samanbeer/bambulab_kinda_smart_light/KiCAD_project/kicad_BOM_export.csv

Reference | Qty | Value | Footprint
D1,D2 | 2 | 1N4007 | Diode_THT:D_DO-41_SOD81_P2.54mm_Vertical_AnodeUp
D3 | 1 | LED | LED_THT:LED_D3.0mm
J1,J2 | 2 | Screw_Terminal_01x02 | TerminalBlock_RND:TerminalBlock_RND_205-00001_1x02_P5.00mm_Horizontal
J3 | 1 | INPUT__DC_JACK_24V | Connector_AMASS:AMASS_XT30U-F_1x02_P5.0mm_Vertical
J4 | 1 | FUSE_500mA | Connector_AMASS:AMASS_XT30U-F_1x02_P5.0mm_Vertical
Q1,Q2 | 2 | IRLZ44N | Package_TO_SOT_THT:TO-220-3_Vertical
R1,R4 | 2 | 100R | Resistor_SMD:R_0805_2012Metric_Pad1.20x1.40mm_HandSolder
R2,R3 | 2 | 10k | Resistor_SMD:R_0805_2012Metric_Pad1.20x1.40mm_HandSolder
R6 | 1 | 1k | Resistor_SMD:R_0805_2012Metric_Pad1.20x1.40mm_HandSolder
SW1,SW2 | 2 | SW_SPDT | Connector_PinSocket_2.54mm:PinSocket_1x03_P2.54mm_Vertical
U1 | 1 | XIAO-ESP32-C3-SMD | Seeed_Studio_XIAO_Series:XIAO-ESP32-C3-SMD
