samanbeer/bambulab_kinda_smart_light/quick_order_TME.csv

Customer's symbol | Symbol | Manufacturer part number | Manufacturer | Amount | Unit | Net price | Gross price | Net value | Gross value | Currency
 | 1N5819-DIO | 1N5819 | DIOTEC SEMICONDUCTOR | 2 | pcs | 5.6433 | 6.77 | 11.19 | 13.54 | CZK
 | L-934LID | L-934LID | KINGBRIGHT ELECTRONIC | 1 | pcs | 1.8738 | 2.36 | 1.95 | 2.36 | CZK
 | DG301-5.0-2P12 | DG301-5.0-02P-12-00A(H) | DEGSON ELECTRONICS | 2 | pcs | 3.848 | 4.63 | 7.65 | 9.26 | CZK
 | PC-GM2.5 | PC-GM2.5 | NINIGI | 1 | pcs | 76.52 | 92.59 | 76.52 | 92.59 | CZK
 | R3-12E | R3-12E | SCI | 2 | pcs | 20.397 | 24.73 | 40.88 | 49.46 | CZK
 | IRLZ44NPBF | IRLZ44NPBF | INFINEON TECHNOLOGIES | 2 | pcs | 33.753 | 40.785 | 67.41 | 81.57 | CZK
 | CRCW0805100RFKTABC | CRCW0805100RFKTABC | VISHAY | 2 | pcs | 0.22461 | 0.295 | 0.49 | 0.59 | CZK
 | CRCW080510K0FKEA | CRCW080510K0FKEA | VISHAY | 2 | pcs | 0.16913 | 0.145 | 0.24 | 0.29 | CZK
 | RC0805FR-071K | RC0805FR-071KL | YAGEO | 1 | pcs | 1.23792 | 1.48 | 1.22 | 1.48 | CZK
 | SEEED-113991054 | XIAO ESP32C3 | SEEED STUDIO | 1 | pcs | 139.04 | 168.24 | 139.04 | 168.24 | CZK
 | BSI-10 | SSI-10 | SUNGMUN ELECTRONICS | 2 | pcs | 12.654 | 15.315 | 25.31 | 30.63 | CZK
