samanbeer/bambulab_kinda_smart_light/CAD/CASE_Bottom.step

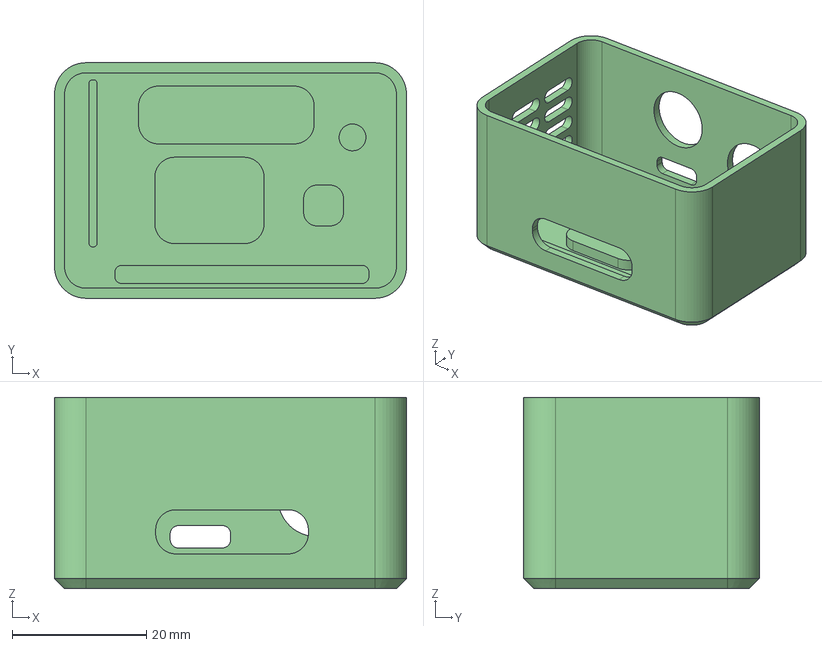
[picture p15: CAD file, 2026-10-30]
CAD/CASE_Bottom.step
52.4 x 35.1 x 28.5 mm
