samanbeer/bambulab_kinda_smart_light/KiCAD_project/kicad_3dmodels/XIAO ESP32C3--3DModel-STEP-269445.STEP

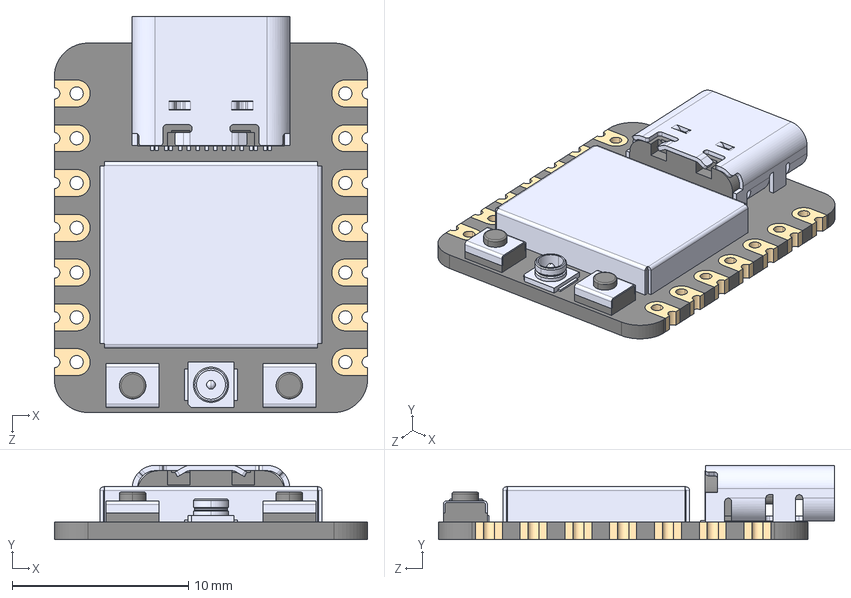
[picture p16: CAD file, 2026-10-30]
KiCAD_project/kicad_3dmodels/XIAO ESP32C3--3DModel-STEP-269445.STEP
17.8 x 4.21 x 22.5 mm
