samanbeer/bambulab_kinda_smart_light/CAD/CASE_lid.step

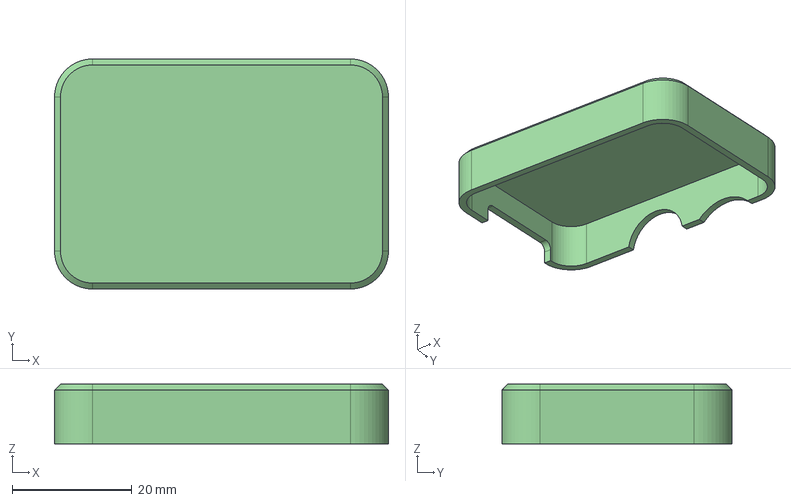
[picture p17: CAD file, 2026-10-30]
CAD/CASE_lid.step
55.7 x 38.4 x 10.0 mm
