samanbeer/bambulab_kinda_smart_light/KiCAD_project/kicad_3dmodels/Same_Sky_TB006-508-02BE.step

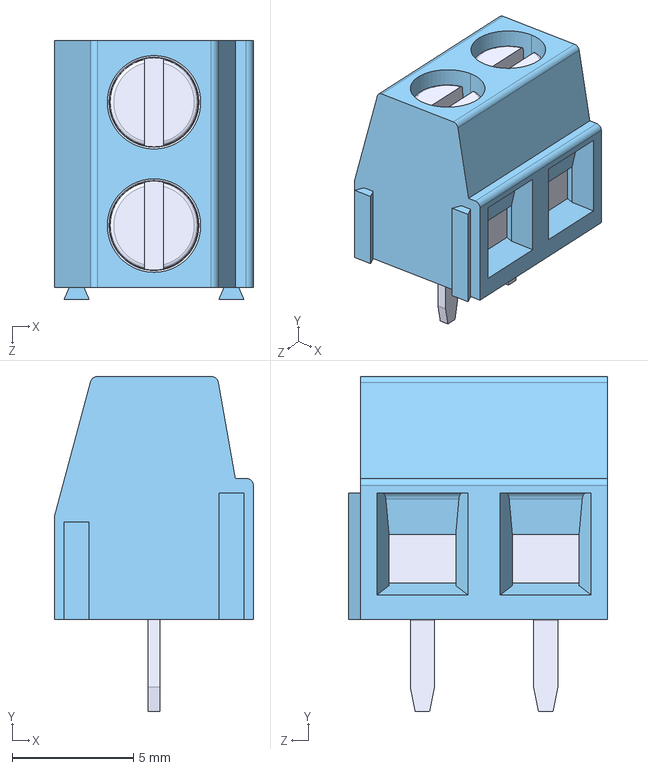
[picture p18: CAD file, 2026-10-30]
KiCAD_project/kicad_3dmodels/Same_Sky_TB006-508-02BE.step
8.20 x 13.8 x 10.7 mm
