samanbeer/bambulab_kinda_smart_light/CAD/KiCAD_PCB_export.step

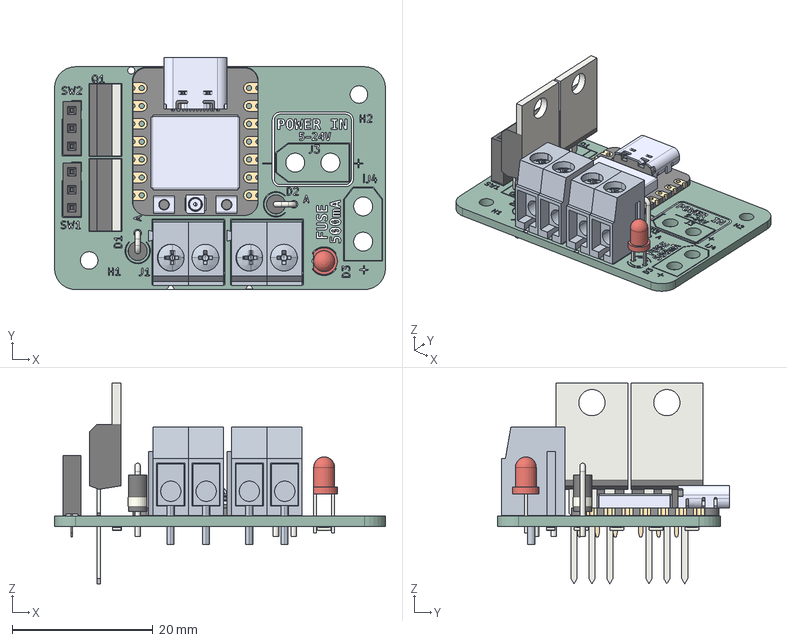
[picture p19: CAD file, 2026-10-30]
CAD/KiCAD_PCB_export.step
47.0 x 33.0 x 28.5 mm
TO-220-3_Vertical x 2
LED_D3.0mm
D_DO-41_SOD81_P2.54mm_Vertical_AnodeUp x 2
PinSocket_1x03_P2.54mm_Vertical x 2
CTB1202,2BK x 2
R_0805_2012Metric x 5
smarthome1_silkscreen x 2
smarthome1_PCB
