samanbeer/bambulab_kinda_smart_light/KiCAD_project/kicad_3dmodels/RND 205-00001--3DModel-STEP-269445.STEP

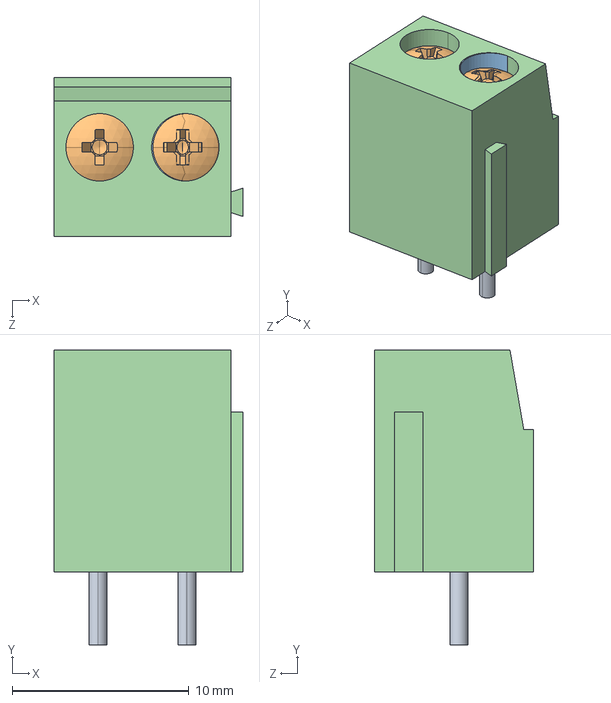
[picture p20: CAD file, 2026-10-30]
KiCAD_project/kicad_3dmodels/RND 205-00001--3DModel-STEP-269445.STEP
10.7 x 16.7 x 9.02 mm
