samanbeer/bambulab_kinda_smart_light/(list of files, cad)

Other CAD files:
CAD/CASE_full_assembly.f3z
