samanbeer/bambulab_kinda_smart_light/KiCAD_project/smarthome1.kicad_pcb

## KiCad design KiCAD_project/smarthome1.kicad_pcb (2026-10-30)

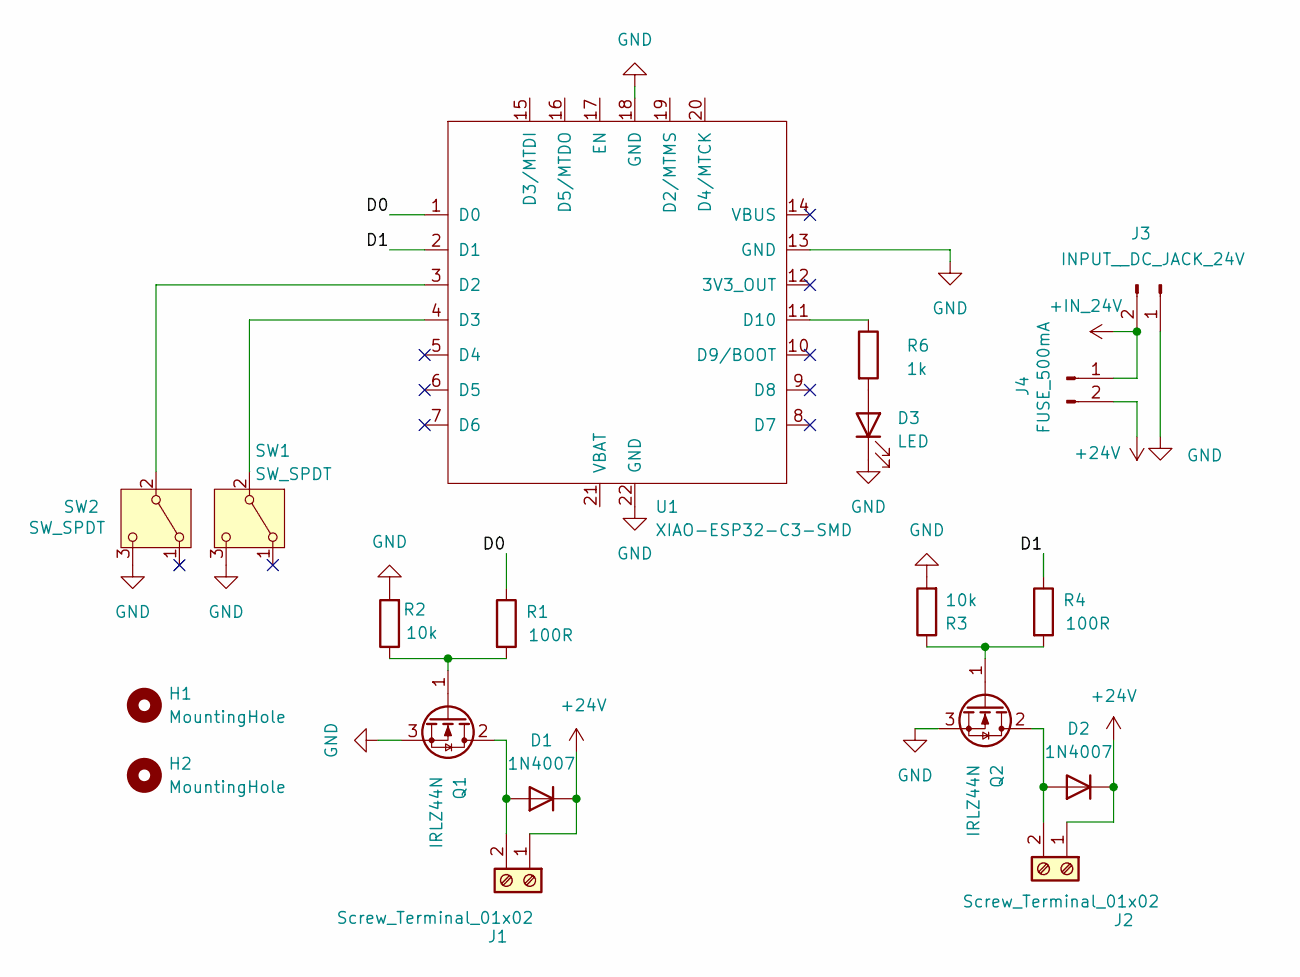
[picture p21: schematic smarthome1.kicad_sch]

Parts:
D1, D2: 1N4007; D_DO-41_SOD81_P2.54mm_Vertical_AnodeUp
D3: LED; LED_D3.0mm
H1, H2: MountingHole; MountingHole_2.5mm
J1, J2: Screw_Terminal_01x02; TerminalBlock_RND_205-00001_1x02_P5.00mm_Horizontal
J3: INPUT__DC_JACK_24V; AMASS_XT30U-F_1x02_P5.0mm_Vertical
J4: FUSE_500mA; AMASS_XT30U-F_1x02_P5.0mm_Vertical
Q1, Q2: IRLZ44N; TO-220-3_Vertical
R1, R4: 100R; R_0805_2012Metric_Pad1.20x1.40mm_HandSolder
R2, R3: 10k; R_0805_2012Metric_Pad1.20x1.40mm_HandSolder
R6: 1k; R_0805_2012Metric_Pad1.20x1.40mm_HandSolder
SW1, SW2: SW_SPDT; PinSocket_1x03_P2.54mm_Vertical
U1: XIAO-ESP32-C3-SMD

Connections:
+24V: D1.1 (K), D2.1 (K), J1.1, J2.1, J4.2
+IN_24V: J3.2, J4.1
/D0: R1.1, U1.1 (D0)
/D1: R4.1, U1.2 (D1)
GND: D3.1 (K), J3.1, Q1.3 (S), Q2.3 (S), R2.2, R3.2, SW1.3 (C), SW2.3 (C), U1.13 (GND), U1.18 (GND), U1.22 (GND)
unnamed: D1.2 (A), J1.2, Q1.2 (D)
unnamed: D2.2 (A), J2.2, Q2.2 (D)
unnamed: D3.2 (A), R6.2
unnamed: Q1.1 (G), R1.2, R2.1
unnamed: Q2.1 (G), R3.1, R4.2
unnamed: SW1.2 (B), U1.4 (D3)
unnamed: SW2.2 (B), U1.3 (D2)
unnamed: R6.1, U1.11 (D10)

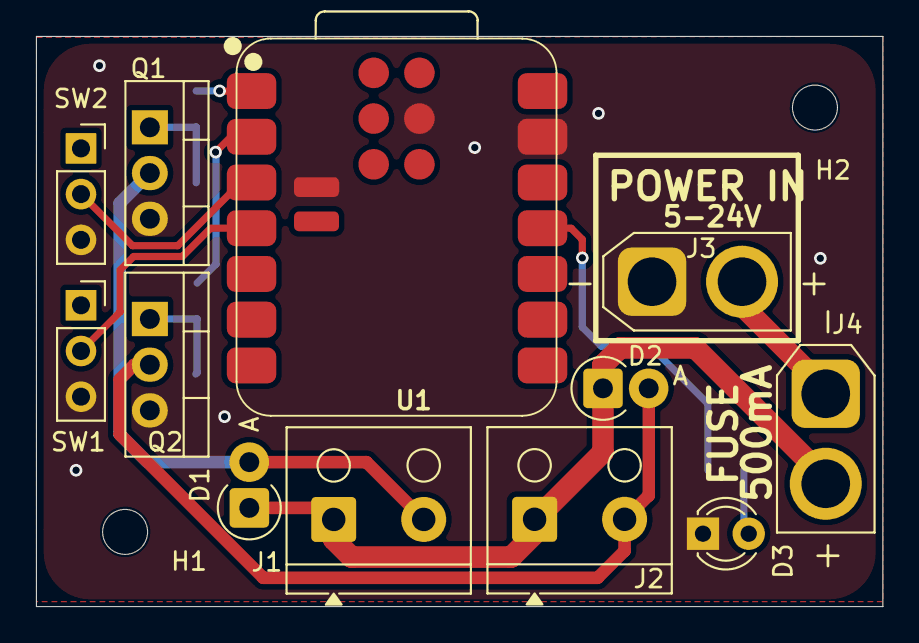
[picture p22: board smarthome1.kicad_pcb from above]

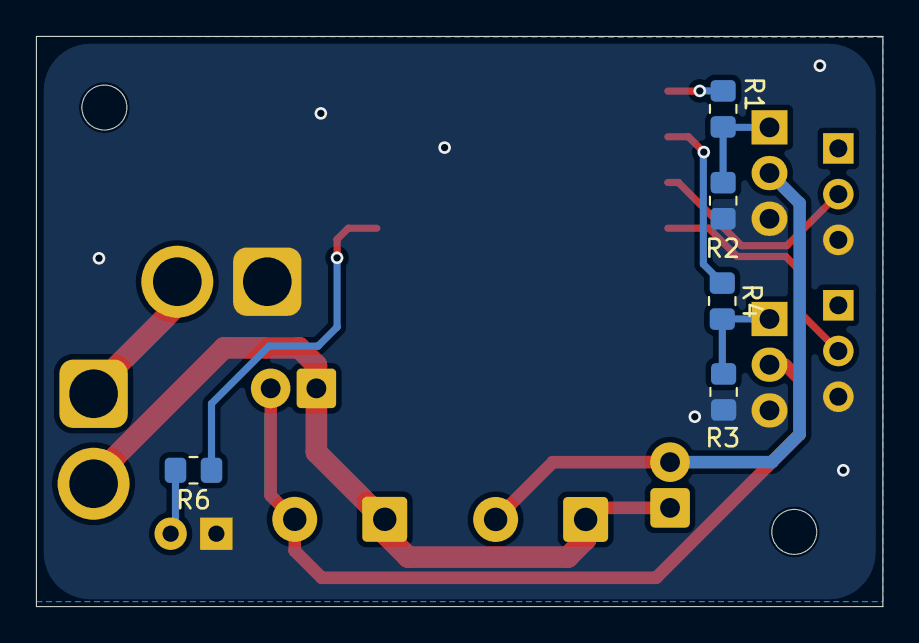
[picture p23: board smarthome1.kicad_pcb from below]

Board: 2 copper layers, 47.0 x 31.7 mm, 19 parts (5 on the bottom side), 13 nets.
